hoffman373/PicoTide/PicoTide.kicad_pcb

## KiCad design PicoTide.kicad_pcb (2026-10-06)

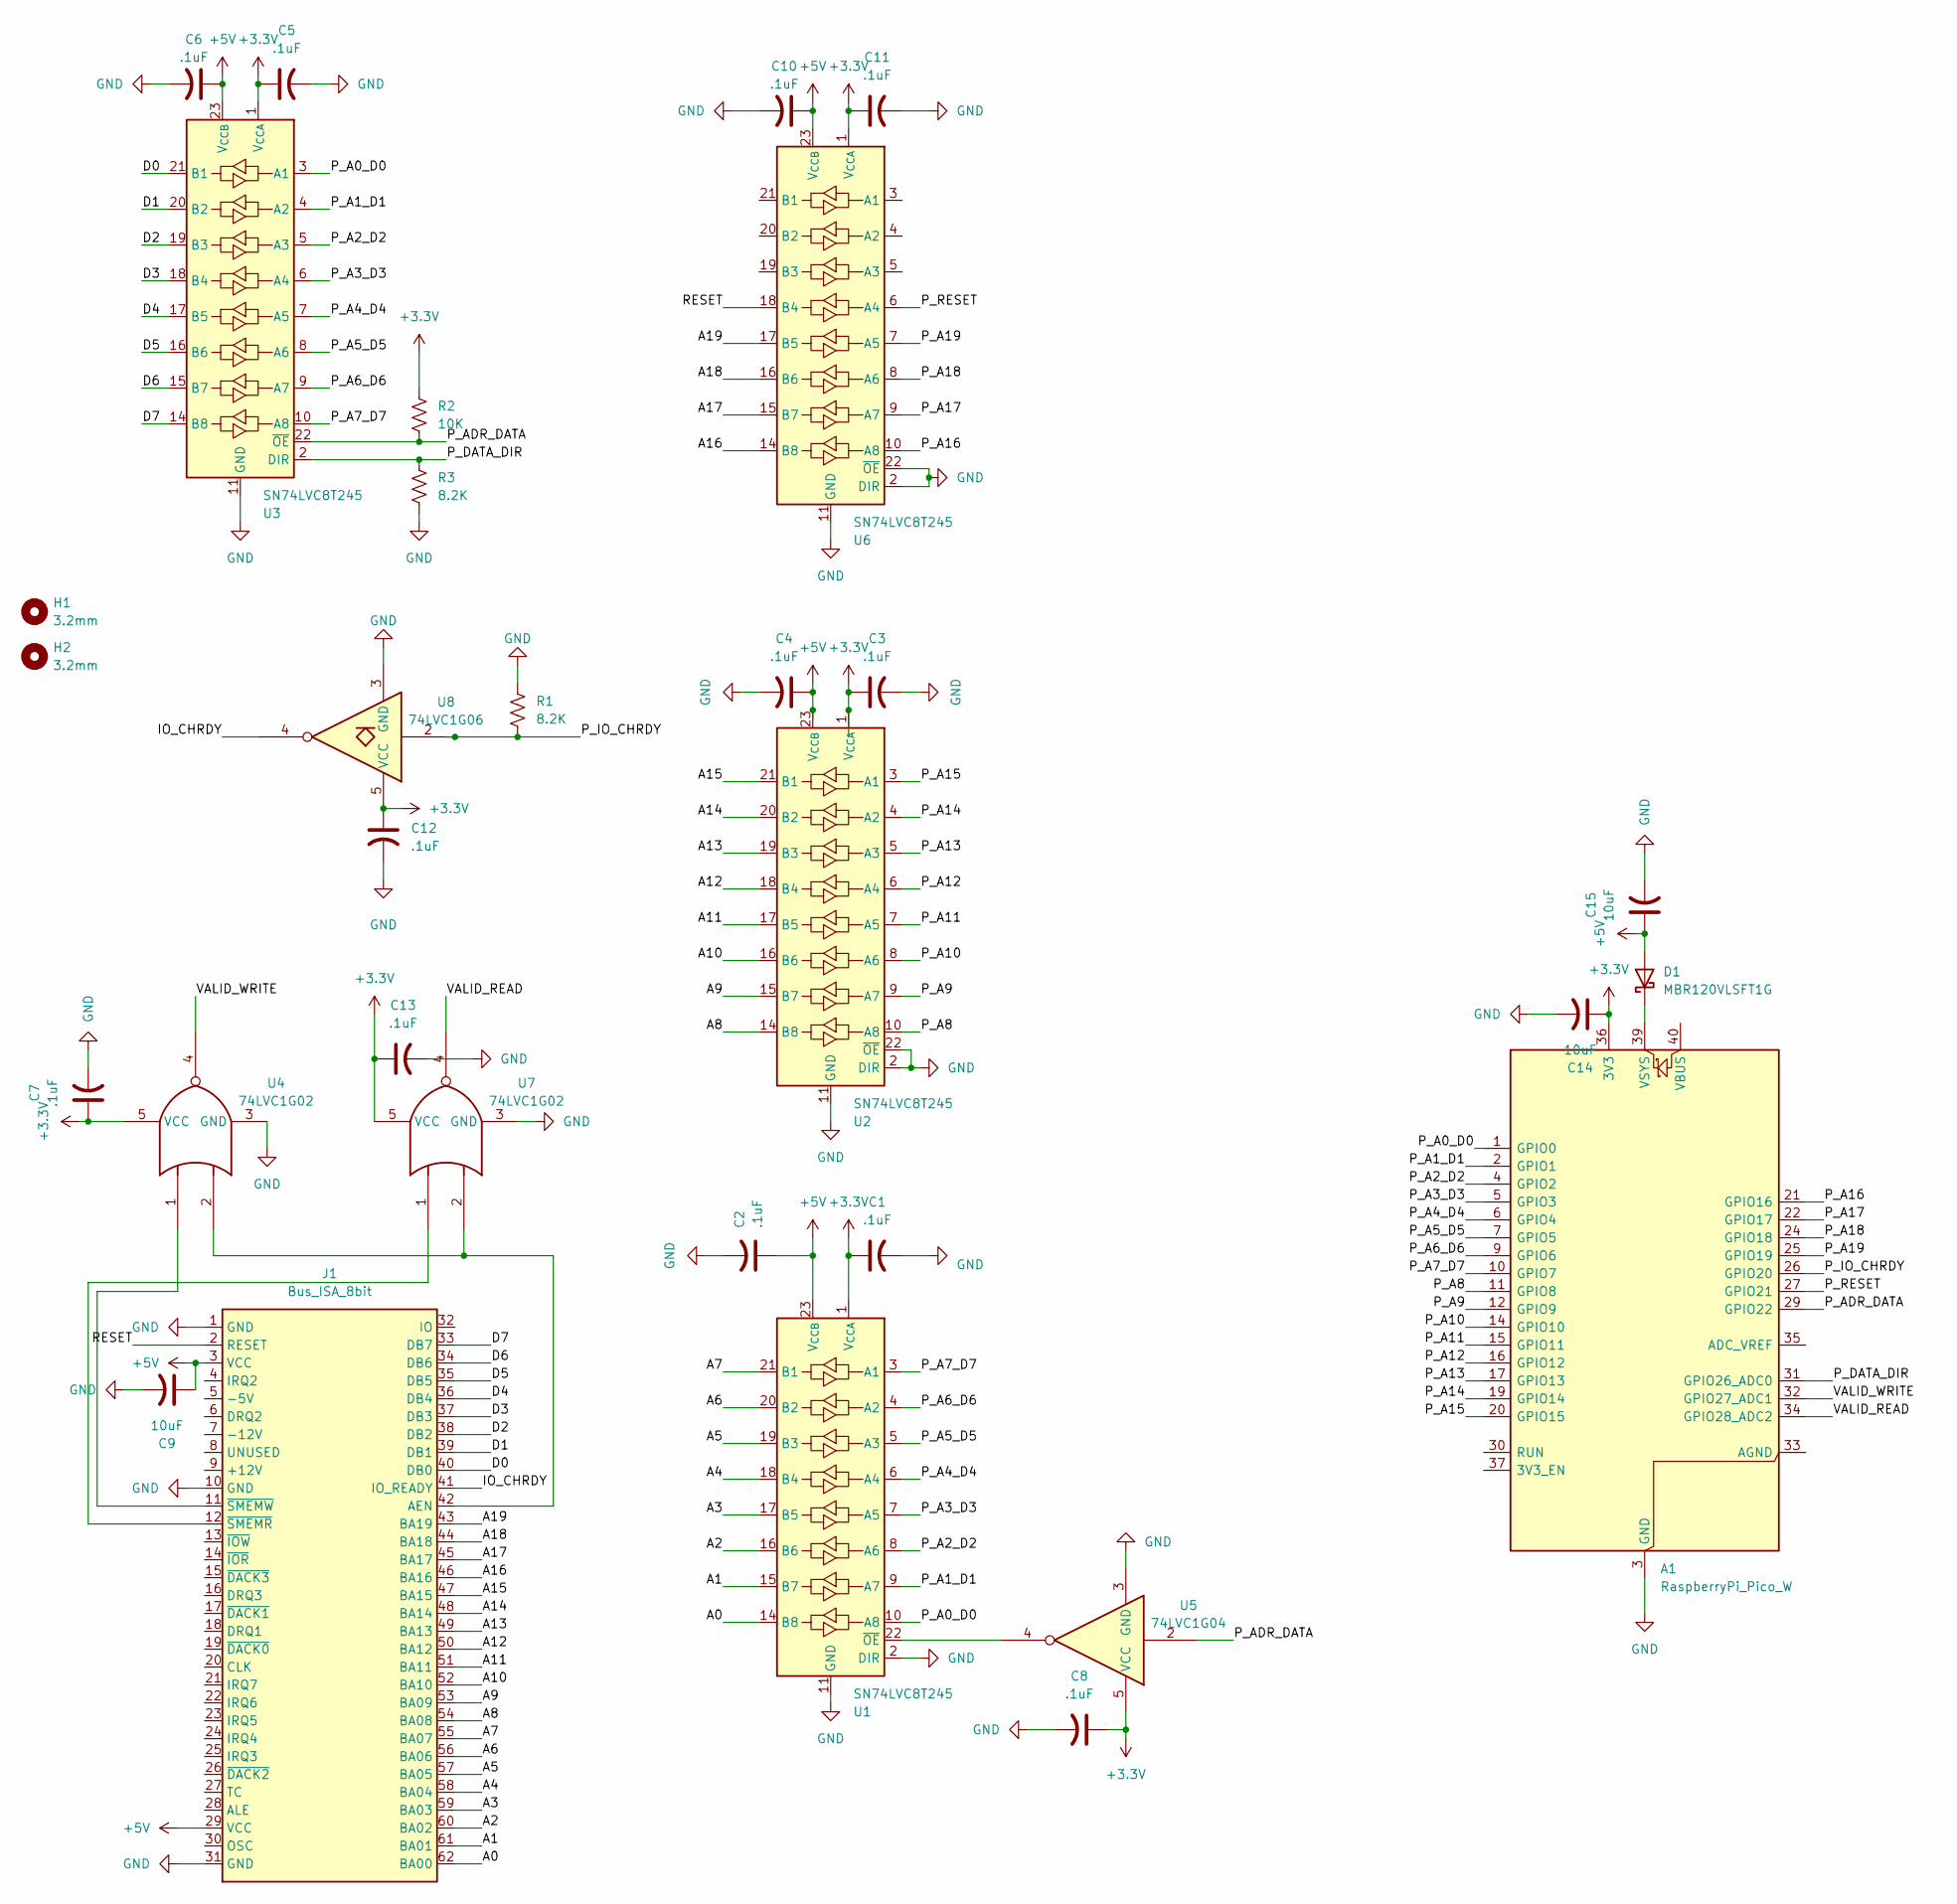
[picture p1: schematic PicoTide.kicad_sch]

Parts:
A1: RaspberryPi_Pico_W; RaspberryPi_Pico_MountingHole
C1, C2, C3, C4, C5, C6, C7, C8, C10, C11, C12, C13: .1uF; C_0805_2012Metric_Pad1.18x1.45mm_HandSolder
C9, C14, C15: 10uF; C_1206_3216Metric_Pad1.33x1.80mm_HandSolder
D1: MBR120VLSFT1G; D_SOD-123F
H1, H2: 3.2mm; MountingHole_3.2mm_M3
J1: Bus_ISA_8bit; PC_AT_8BIT
R1, R3: 8.2K; R_0805_2012Metric_Pad1.20x1.40mm_HandSolder
R2: 10K; R_0805_2012Metric_Pad1.20x1.40mm_HandSolder
U1, U2, U3, U6: SN74LVC8T245; SOIC-24W_7.5x15.4mm_P1.27mm
U4, U7: 74LVC1G02; SOT-23-5_HandSoldering
U5: 74LVC1G04; SOT-23-5_HandSoldering
U8: 74LVC1G06; SOT-23-5_HandSoldering

Connections:
+3.3V: A1.36 (3V3), C1.1, C3.1, C5.1, C7.1, C8.1, C11.1, C12.1, C13.1, C14.1, R2.1, U1.1 (V_{CCA}), U2.1 (V_{CCA}), U3.1 (V_{CCA}), U4.5 (VCC), U5.5 (VCC), U6.1 (V_{CCA}), U7.5 (VCC), U8.5 (VCC)
+5V: C2.1, C4.1, C6.1, C9.1, C10.1, C15.1, D1.2 (A), J1.3 (VCC), J1.29 (VCC), U1.23 (V_{CCB}), U1.24 (V_{CCB}), U2.23 (V_{CCB}), U2.24 (V_{CCB}), U3.23 (V_{CCB}), U3.24 (V_{CCB}), U6.23 (V_{CCB}), U6.24 (V_{CCB})
/A0: J1.62 (BA00), U1.14 (B8)
/A1: J1.61 (BA01), U1.15 (B7)
/A2: J1.60 (BA02), U1.16 (B6)
/A3: J1.59 (BA03), U1.17 (B5)
/A4: J1.58 (BA04), U1.18 (B4)
/A5: J1.57 (BA05), U1.19 (B3)
/A6: J1.56 (BA06), U1.20 (B2)
/A7: J1.55 (BA07), U1.21 (B1)
/A8: J1.54 (BA08), U2.14 (B8)
/A9: J1.53 (BA09), U2.15 (B7)
/A10: J1.52 (BA10), U2.16 (B6)
/A11: J1.51 (BA11), U2.17 (B5)
/A12: J1.50 (BA12), U2.18 (B4)
/A13: J1.49 (BA13), U2.19 (B3)
/A14: J1.48 (BA14), U2.20 (B2)
/A15: J1.47 (BA15), U2.21 (B1)
/A16: J1.46 (BA16), U6.14 (B8)
/A17: J1.45 (BA17), U6.15 (B7)
/A18: J1.44 (BA18), U6.16 (B6)
/A19: J1.43 (BA19), U6.17 (B5)
/D0: J1.40 (DB0), U3.21 (B1)
/D1: J1.39 (DB1), U3.20 (B2)
/D2: J1.38 (DB2), U3.19 (B3)
/D3: J1.37 (DB3), U3.18 (B4)
/D4: J1.36 (DB4), U3.17 (B5)
/D5: J1.35 (DB5), U3.16 (B6)
/D6: J1.34 (DB6), U3.15 (B7)
/D7: J1.33 (DB7), U3.14 (B8)
/IO_CHRDY: J1.41 (IO_READY), U8.4
/P_A0_D0: A1.1 (GPIO0), U1.10 (A8), U3.3 (A1)
/P_A1_D1: A1.2 (GPIO1), U1.9 (A7), U3.4 (A2)
/P_A2_D2: A1.4 (GPIO2), U1.8 (A6), U3.5 (A3)
/P_A3_D3: A1.5 (GPIO3), U1.7 (A5), U3.6 (A4)
/P_A4_D4: A1.6 (GPIO4), U1.6 (A4), U3.7 (A5)
/P_A5_D5: A1.7 (GPIO5), U1.5 (A3), U3.8 (A6)
/P_A6_D6: A1.9 (GPIO6), U1.4 (A2), U3.9 (A7)
/P_A7_D7: A1.10 (GPIO7), U1.3 (A1), U3.10 (A8)
/P_A8: A1.11 (GPIO8), U2.10 (A8)
/P_A9: A1.12 (GPIO9), U2.9 (A7)
/P_A10: A1.14 (GPIO10), U2.8 (A6)
/P_A11: A1.15 (GPIO11), U2.7 (A5)
/P_A12: A1.16 (GPIO12), U2.6 (A4)
/P_A13: A1.17 (GPIO13), U2.5 (A3)
/P_A14: A1.19 (GPIO14), U2.4 (A2)
/P_A15: A1.20 (GPIO15), U2.3 (A1)
/P_A16: A1.21 (GPIO16), U6.10 (A8)
/P_A17: A1.22 (GPIO17), U6.9 (A7)
/P_A18: A1.24 (GPIO18), U6.8 (A6)
/P_A19: A1.25 (GPIO19), U6.7 (A5)
/P_ADR_DATA: A1.29 (GPIO22), R2.2, U3.22 (~OE), U5.2
/P_DATA_DIR: A1.31 (GPIO26_ADC0), R3.1, U3.2 (DIR)
/P_IO_CHRDY: A1.26 (GPIO20), R1.2, U8.2
/P_RESET: A1.27 (GPIO21), U6.6 (A4)
/RESET: J1.2 (RESET), U6.18 (B4)
/VALID_READ: A1.34 (GPIO28_ADC2), U7.4
/VALID_WRITE: A1.32 (GPIO27_ADC1), U4.4
GND: A1.3 (GND), A1.8 (GND), A1.13 (GND), A1.18 (GND), A1.23 (GND), A1.28 (GND), A1.38 (GND), C1.2, C2.2, C3.2, C4.2, C5.2, C6.2, C7.2, C8.2, C9.2, C10.2, C11.2, C12.2, C13.2, C14.2, C15.2, J1.1 (GND), J1.10 (GND), J1.31 (GND), R1.1, R3.2, U1.2 (DIR), U1.11 (GND), U1.12 (GND), U1.13 (GND), U2.2 (DIR), U2.11 (GND), U2.12 (GND), U2.13 (GND), U2.22 (~OE), U3.11 (GND), U3.12 (GND), U3.13 (GND), U4.3 (GND), U5.3 (GND), U6.2 (DIR), U6.11 (GND), U6.12 (GND), U6.13 (GND), U6.22 (~OE), U7.3 (GND), U8.3 (GND)
unnamed: A1.39 (VSYS), D1.1 (K)
unnamed: J1.42 (AEN), U4.2, U7.2
unnamed: J1.12 (~SMEMR), U7.1
unnamed: J1.11 (~SMEMW), U4.1
unnamed: U1.22 (~OE), U5.4

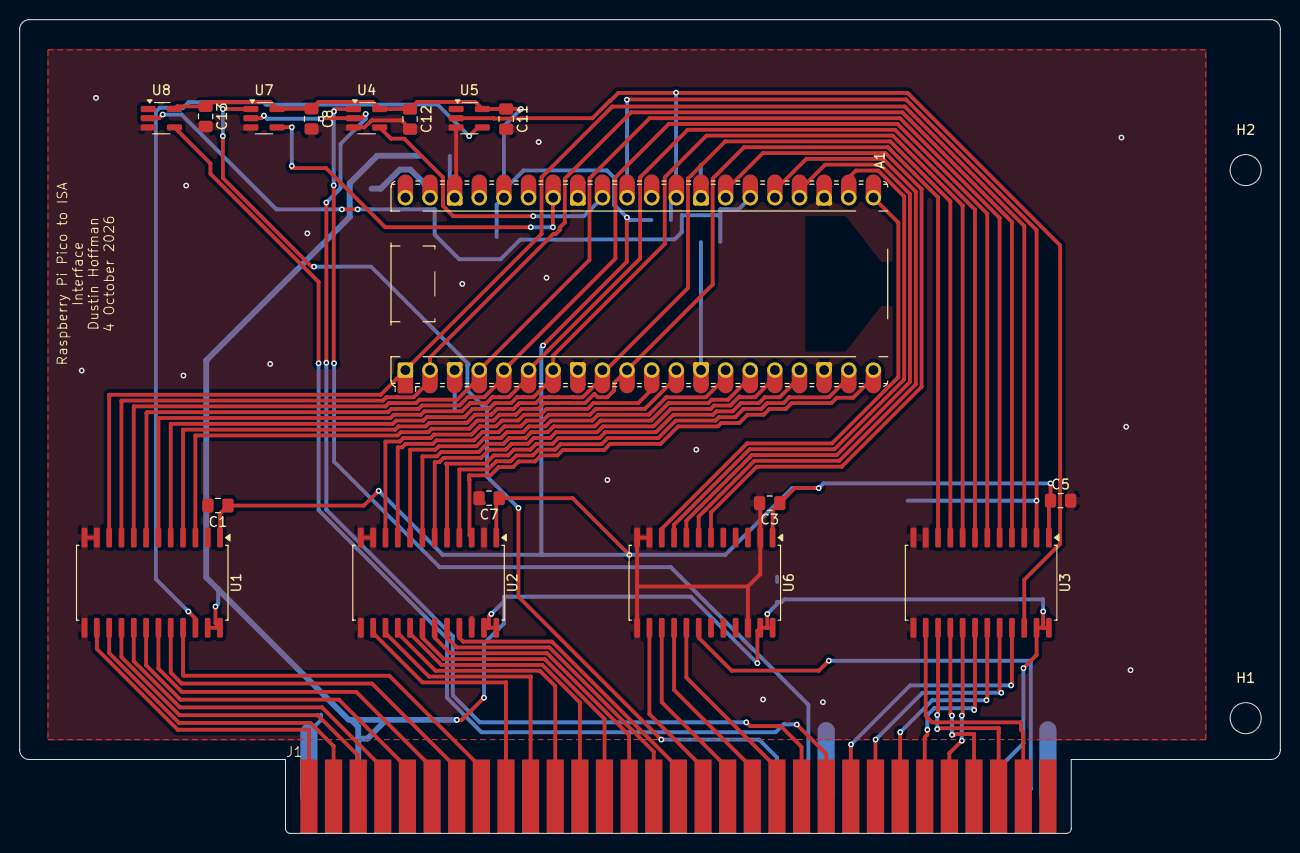
[picture p2: board PicoTide.kicad_pcb from above]

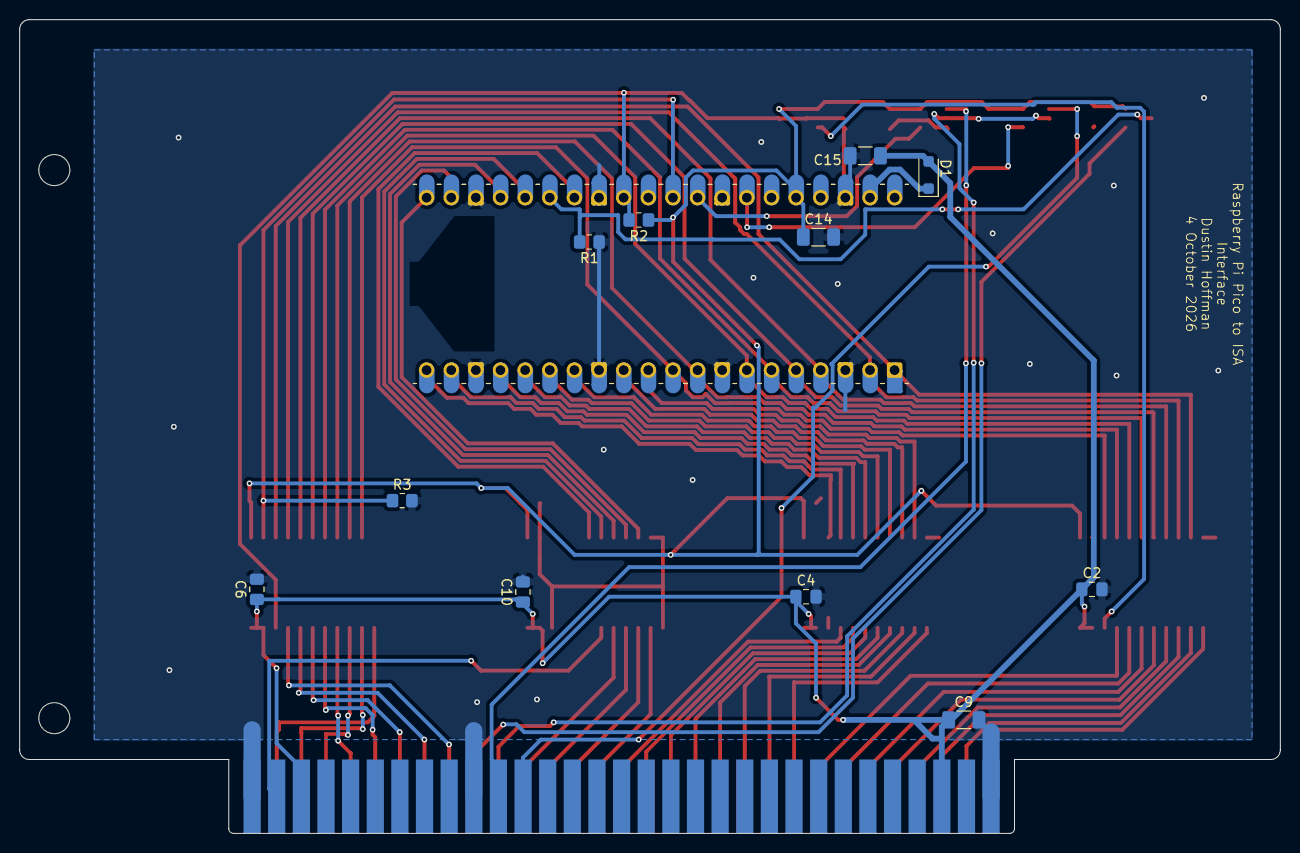
[picture p3: board PicoTide.kicad_pcb from below]

Board: 2 copper layers, 130.0 x 83.9 mm, 31 parts (11 on the bottom side), 64 nets.
